ha7dcd/QRPi_WSPR_PCB/Eagle/20m_RPI_WSPR_TX_BOM_SMDmount.xlsx

Sheet: BOM_20m_RPI_WSPR_TX
 | BOM Version 1V1
Qty | Value | Newark website link | Device | Package | Parts | Description | DESCR | DISTRI | DISTRINR | MANUF | MANUFNR | MPN | OC_FARNELL | OC_NEWARK | PACKAGE | SUPPLIER | VENDOR
1 | 0.18uH | http://www.newark.com/taiyo-yuden/lbm2016tr18j/inductor-180nh-560ma-5-500mhz/dp/82T8627 | INDUCTOR_L_1210 | L1210 | L2 |  | Inductor, wirewound |  |  | TDK | NLCV32 series
2 | 0.27uH | http://www.newark.com/taiyo-yuden/brl3225tr27m/inductor-270nh-4-5a-20-390mhz/dp/82T8566 | INDUCTOR_L_1210 | L1210 | L0, L4 |  | Inductor, wirewound |  |  | TDK | NLCV32 series
2 | 0.56uH | http://www.newark.com/tdk/nlv32t-r56j-pf/signal-line-ind-56nh-450ma-5-180mhz/dp/89R9024 | INDUCTOR_L_1210 | L1210 | L6, L7 |  | Inductor, wirewound |  |  | TDK | NLCV32 series
1 | 1.2k | http://www.newark.com/yageo/rc0402jr-071k2l/thick-film-resistor-1-2kohm-62/dp/68R2086 | R-US_R0402 | R0402 | R2 | RESISTOR, American symbol
2 | 10nF | http://www.newark.com/multicomp/mc0603b103m500ct/ceramic-capacitor-0-01uf-50v-x7r/dp/06R4922 | CAP-SMD0603 | 0603 | C5, C11
1 | 1k | http://www.newark.com/yageo/rc0402jr-131kl/thick-film-resistor-1kohm-62-5mw/dp/68R0037 | R-US_R0402 | R0402 | R3 | RESISTOR, American symbol
2 | 2.7uH | http://www.newark.com/taiyo-yuden/lbm2016t2r7j/inductor-2-7uh-310ma-5-55mhz-smd/dp/82T8636 | INDUCTOR_L_1210 | L1210 | L1, L3 |  | Inductor, wirewound |  |  | TDK | NLCV32 series
3 | 220nF | http://www.newark.com/multicomp/mc0603f224z160ct/ceramic-capacitor-0-22uf-16v-y5v/dp/06R5085 | CAP-SMD0603 | 0603 | C_DC1, C_DC2, C_DC3
2 | 330p | http://www.newark.com/multicomp/mc0603b331k500ct/ceramic-capacitor-330pf-50v-x7r/dp/06R4989 | CAP-SMD0603 | 0603 | C10, C21
2 | 390p | http://www.newark.com/tdk/c1608c0g1h391j080aa/ceramic-capacitor-390pf-50v-c0g/dp/90R7654 | CAP-SMD0603 | 0603 | C0, C4
2 | 39p | http://www.newark.com/multicomp/mc0603n390j500ct/ceramic-capacitor-39pf-50v-c0g/dp/06R5174 | CAP-SMD0603 | 0603 | C1, C3
1 | 470p | http://www.newark.com/multicomp/mc0603b471k101ct/ceramic-capacitor-470pf-100v-x7r/dp/06R5014 | CAP-SMD0603 | 0603 | C2
2 | 47uH | http://www.newark.com/tdk/nlcv32t-470k-pf/power-line-ind-47uh-180ma-10-14mhz/dp/89R8888 | INDUCTOR_L_1210 | L1210 | LC1, LC2 |  | Inductor, wirewound |  |  | TDK | NLCV32 series
1 | 680p | http://www.newark.com/multicomp/mc0603b681k500ct/ceramic-capacitor-680pf-50v-x7r/dp/06R5042 | CAP-SMD0603 | 0603 | C7
1 | MMBF170-7-F | http://www.newark.com/fairchild-semiconductor/mmbf170/mosfet-full-reel/dp/67R2110 | MMBF170-7-F | SOT103P240X110-3N | Q1 | N-CHANNEL ENHANCEMENT MODE FIELD EFFECT TRANSISTOR |  |  |  |  |  | MMBF170-7-F | 1773582 | 51R6804 | SOT-23-3 | DIODES INC.
2 | N.F. |  | CAP-SMD0603 | 0603 | C6, C9
1 | PGB1010603NRHF Optional! | http://www.newark.com/littelfuse/pgb1010603nr/tvs-diode-24v-0603/dp/77J9736 | SMF33A-GS08_ESD0603 | 0603 | ESD1
1 | TERMINAL_WIRE_2P_17256562P | http://www.newark.com/phoenix-contact/1725656/terminal-block-pcb-2-position/dp/71C4107?ost=3041359 | TERMINAL_WIRE_2P_17256562P | WIRE_CONTACT_2P | ANT | PHOENIX CONTACT 1725656 TERMINAL BLOCK, WIRE TO BRD, 2POS, 20AWG |  | Farnell | 3041359 |  |  |  |  |  |  |  | Phonix
1 | smd header | http://www.newark.com/global-connector-technology/bg120-10-a-0-n-d/board-board-connector-socket-10way/dp/67R8627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 | PINHD-2X7_SMD2X7_CROSSPCB_ASSYM_DUMMY26PIN | 2X7-SMT_CROSSPCB_ASSYM_DUMY26HOLES | CON1 |  | RECEPTACLE, BOARD TO BOARD, 2ROW, 10WAY | Farnell | 2293771 | GLOBAL CONNECTOR TECHNOLOGY | BG120-10-A-0-N-D
 | Yellow marking means = | Not available in the requried size, just smaller footprint. Should fit and solderable.

Sheet: Mount SMD
Part | X [mm] | Y [mm] | Deg | Value | Package
C0 | 10.38 | 17.6 | 270 | 390p | 0603
C1 | 20.95 | 16.7 | 180 | 39p | 0603
C2 | 23.7 | 17.6 | 270 | 470p | 0603
C3 | 34.26 | 16.7 | 180 | 39p | 0603
C4 | 37.12 | 17.6 | 270 | 390p | 0603
C5 | 44.2 | 2.29 | 90 | 10nF | 0603
C6 | 31.46 | 7.45 | 0 | N.F. | 0603
C7 | 28.08 | 6.36 | 270 | 680p | 0603
C9 | 24.68 | 7.43 | 0 | N.F. | 0603
C10 | 21.3 | 6.36 | 270 | 330p | 0603
C11 | 35.78 | 2.37 | 180 | 10nF | 0603
C21 | 34.84 | 6.37 | 270 | 330p | 0603
CON1 | 4.27 | 10.07 | 90 | smd | header
C_DC1 | 10.38 | 13.8 | 270 | 220nF | 0603
C_DC2 | 43.26 | 12.39 | 90 | 220nF | 0603
C_DC3 | 18.53 | 4.97 | 0 | 220nF | 0603
ESD1 | 16.16 | 4.17 | 90 | PGB1010603NRHF | 0603
L0 | 12.64 | 18.3 | 270 | 0.27uH | L1210
L1 | 16.49 | 16.7 | 0 | 2.7uH | L1210
L2 | 25.95 | 18.3 | 270 | 0.18uH | L1210
L3 | 29.81 | 16.7 | 0 | 2.7uH | L1210
L4 | 39.37 | 18.3 | 270 | 0.27uH | L1210
L6 | 31.46 | 5.48 | 180 | 0.56uH | L1210
L7 | 24.65 | 5.47 | 180 | 0.56uH | L1210
LC1 | 42.31 | 2.79 | 270 | 47uH | L1210
LC2 | 38.75 | 3.89 | 270 | 47uH | L1210
Q1 | 40.57 | 7.29 | 270 | MMBF170-7-F | SOT103P240X110-3N
R2 | 42.93 | 6.1 | 90 | 1.2k | R0402
R3 | 44.2 | 6.1 | 270 | 1k | R0402

Sheet: PCB
Two layer
FR4
1.6mm thickness
1oz copper
