ha7dcd/QRPi_WSPR_PCB/KiCad/3dmodels/TerminalBlock_Phoenix_MPT-0,5-2-2.54_1x02_P2.54mm_Horizontal.step

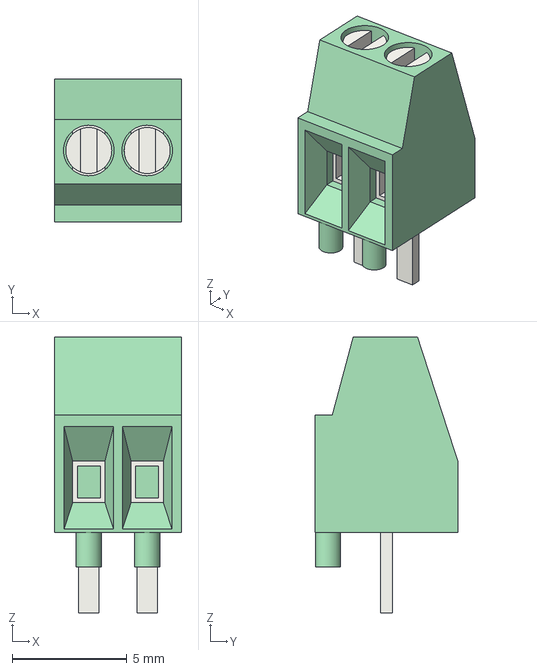
[picture p15: CAD file, 2026-10-26]
KiCad/3dmodels/TerminalBlock_Phoenix_MPT-0,5-2-2.54_1x02_P2.54mm_Horizontal.step
5.54 x 6.20 x 12.0 mm
