ha7dcd/QRPi_WSPR_PCB/KiCad/3dmodels/PinSocket_2x07_P2.54mm_Vertical_SMD.step

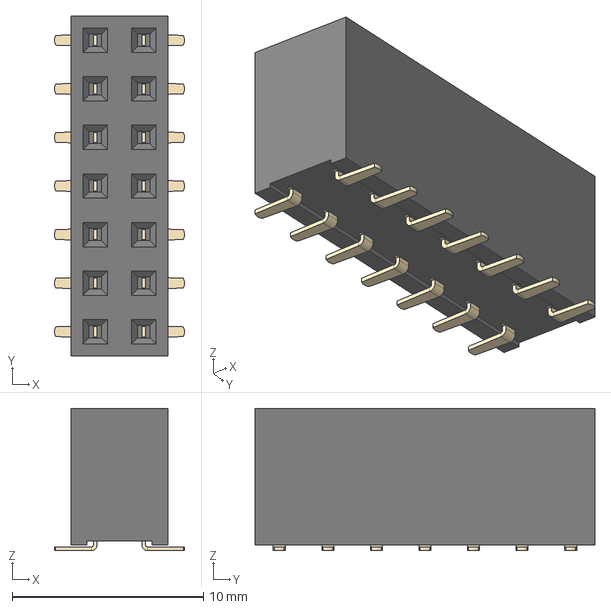
[picture p16: CAD file, 2026-10-26]
KiCad/3dmodels/PinSocket_2x07_P2.54mm_Vertical_SMD.step
6.80 x 17.8 x 7.45 mm
