ha7dcd/QRPi_WSPR_PCB/Eagle/20m_QRPi_1V6_bot.pdf

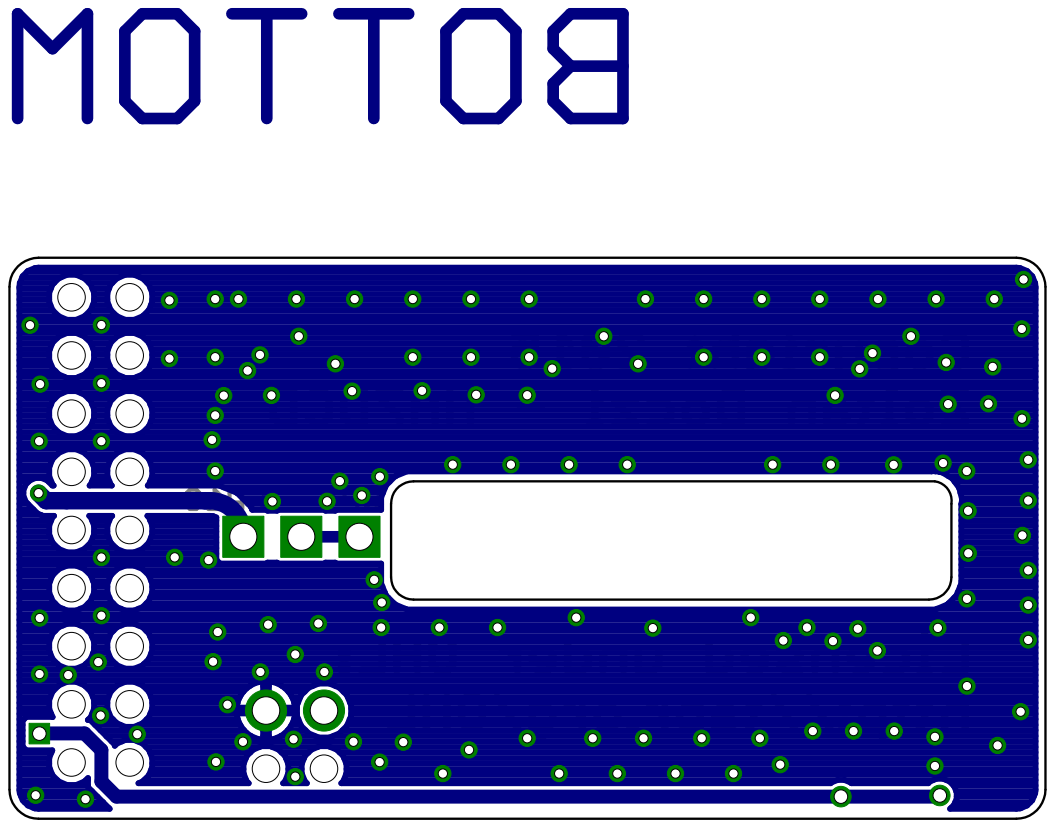
[picture p17: page 1]
