ha7dcd/QRPi_WSPR_PCB/Eagle/20m_QRPi_1V6_sch.pdf

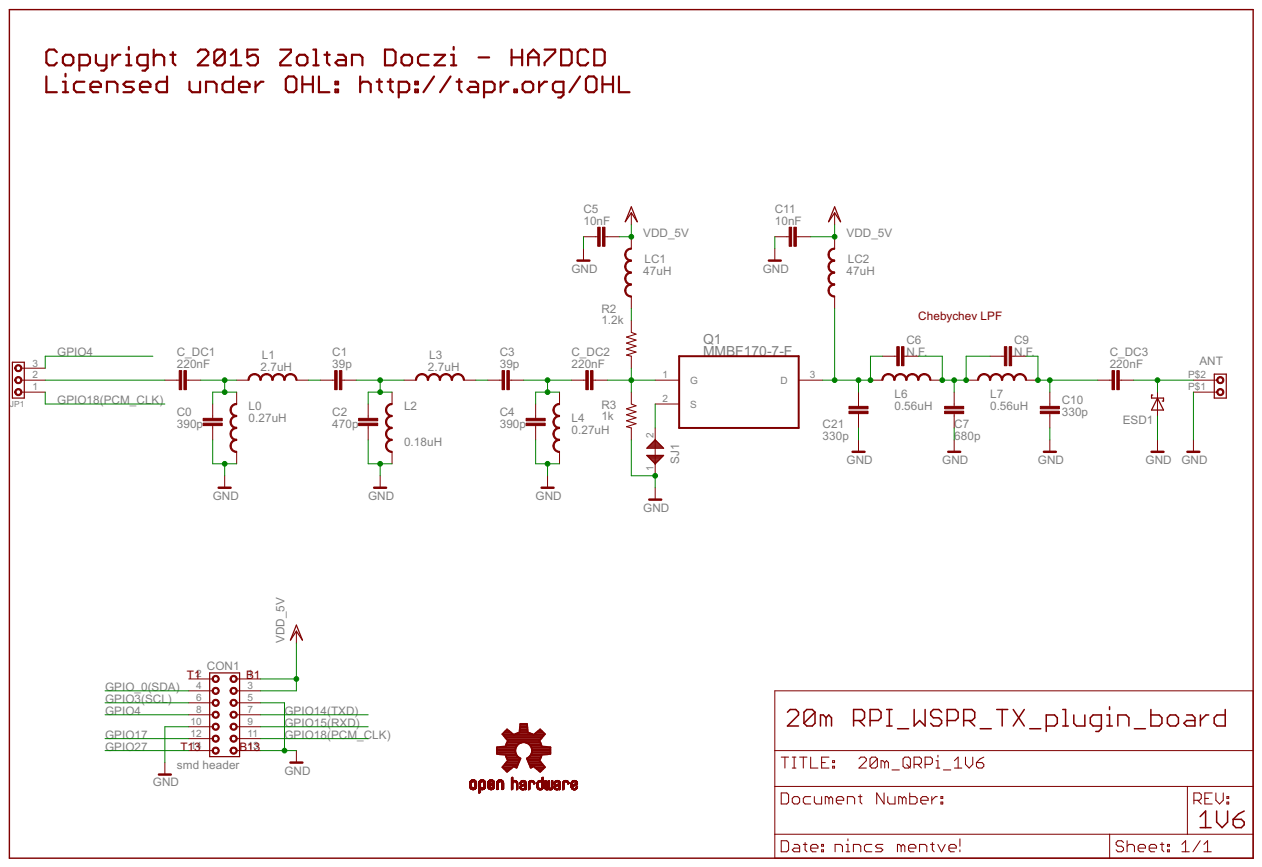
[picture p18: page 1]
