ha7dcd/QRPi_WSPR_PCB/Eagle/20m_QRPi_1V6_top.pdf

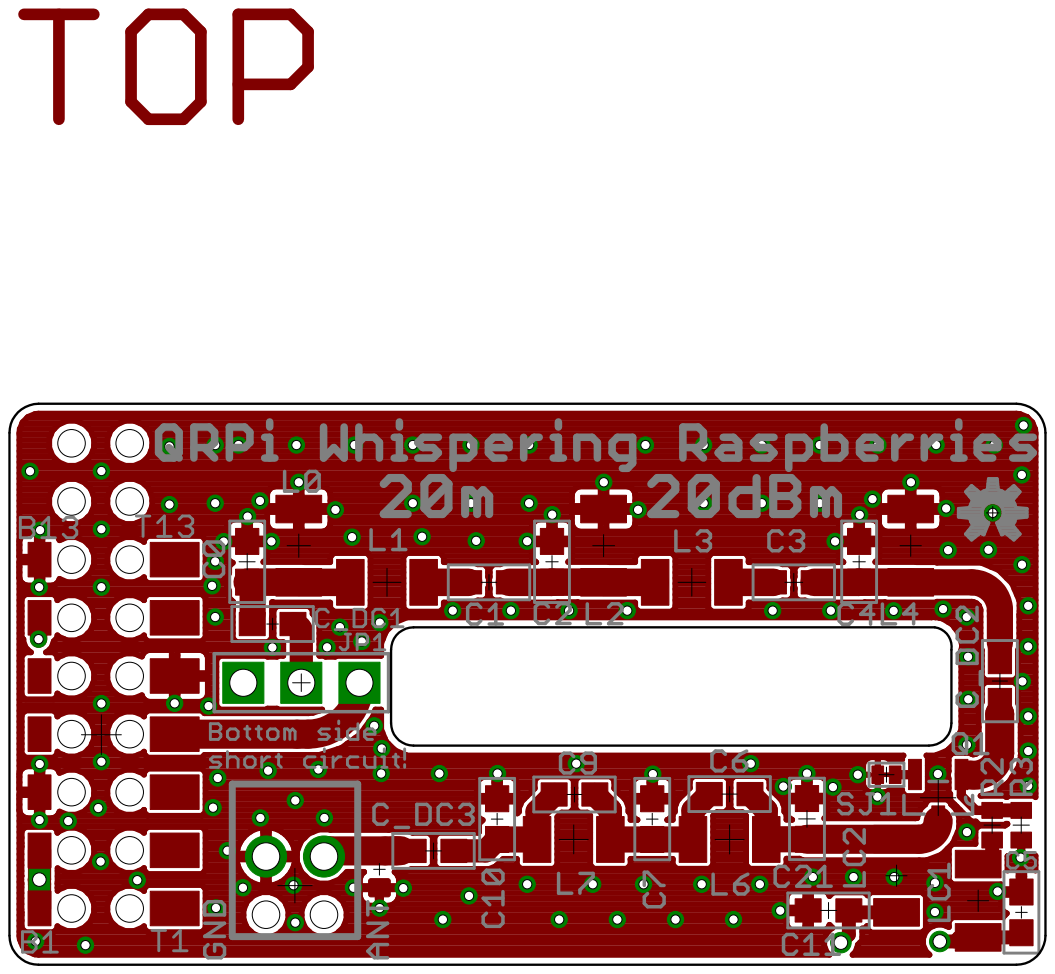
[picture p19: page 1]
