ha7dcd/QRPi_WSPR_PCB/Eagle/20m_QRPi_1V6.brd

## EAGLE design Eagle/20m_QRPi_1V6.brd (2026-10-26)

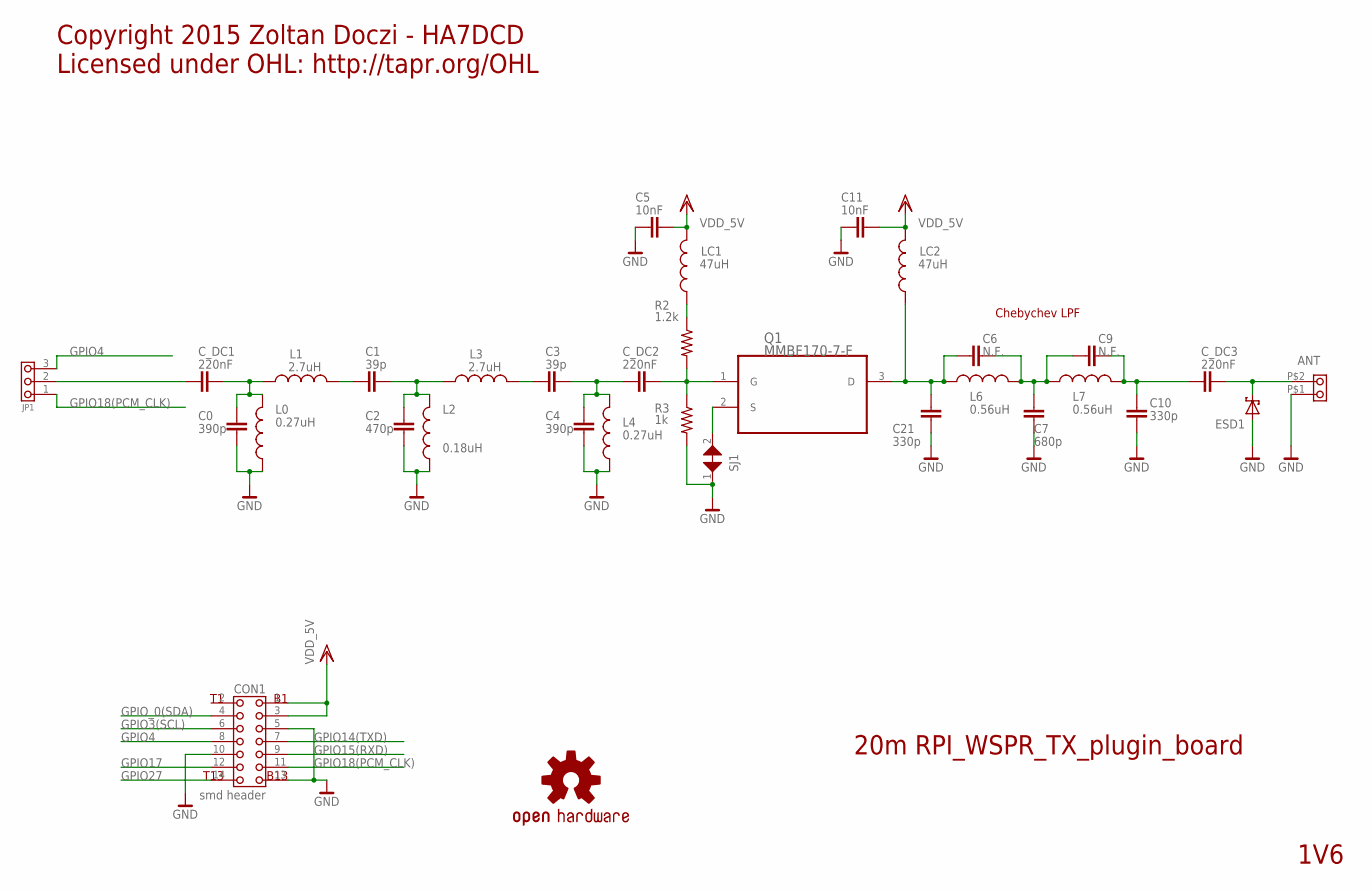
[picture p22: schematic 20m_QRPi_1V6.sch, GPS]

Parts:
ANT: TERMINAL_WIRE_2P_17256562P; WIRE_CONTACT_2P
C0, C4: 390p; 0603
C1, C3: 39p; 0603
C2: 470p; 0603
C5, C11: 10nF; 0603
C6, C9: N.F.; 0603
C7: 680p; 0603
C10, C21: 330p; 0603
CON1: smd header; 2X7-SMT_CROSSPCB_ASSYM_DUMY26HOLES
C_DC1, C_DC2, C_DC3: 220nF; 0603
ESD1: PGB1010603NRHF; 0603
JP1: N.F.; PIN3-B_SHORT23
L0, L4: 0.27uH; L1210
L1, L3: 2.7uH; L1210
L2: 0.18uH; L1210
L6, L7: 0.56uH; L1210
LC1, LC2: 47uH; L1210
Q1: MMBF170-7-F; SOT103P240X110-3N
R2: 1.2k; R0402
R3: 1k; R0402
SJ1: JUMPER_SMD_MICRO_SHORT
U$15: OSHW-LOGOS; OSHW-LOGO-S

Connections:
GND: ANT.P$1 (A), C0.1, C2.1, C4.1, C5.2, C7.1, C10.1, C11.2, C21.1, CON1.5, CON1.10, CON1.13, ESD1.1 (A), L0.1, L2.1, L4.1, R3.2, SJ1.1
GPIO3(SCL): CON1.6
GPIO4: CON1.8, JP1.3
GPIO14(TXD): CON1.7
GPIO15(RXD): CON1.9
GPIO17: CON1.12
GPIO18(PCM_CLK): CON1.11, JP1.1
GPIO27: CON1.14
GPIO_0(SDA): CON1.4
unnamed: C1.2, L1.2
unnamed: C0.2, C_DC1.1, L0.2, L1.1
unnamed: C_DC2.1, Q1.1 (G), R2.2, R3.1
unnamed: Q1.2 (S), SJ1.2
unnamed: LC1.1, R2.1
unnamed: C6.2, C21.2, L6.1, LC2.1, Q1.3 (D)
unnamed: C_DC1.2, JP1.2
unnamed: C3.1, C4.2, C_DC2.2, L4.2
unnamed: C6.1, C7.2, C9.2, L6.2, L7.1
unnamed: C1.1, C2.2, L2.2, L3.1
unnamed: C9.1, C10.2, C_DC3.2, L7.2
unnamed: C3.2, L3.2
unnamed: ANT.P$2 (B), C_DC3.1, ESD1.2 (C)
VDD_5V: C5.1, C11.1, CON1.1, CON1.3, LC1.2, LC2.2

Notes on the sheet:
20m RPI_WSPR_TX_plugin_board
1V6
Chebychev LPF
Copyright 2015 Zoltan Doczi - HA7DCD Licensed under OHL: http://tapr.org/OHL

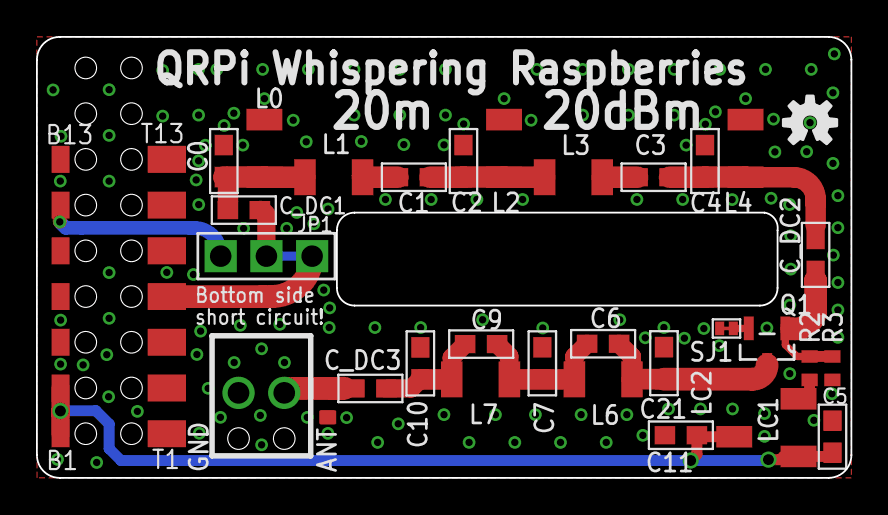
[picture p23: board 20m_QRPi_1V6.brd from above]

Board: 2 copper layers, 45.2 x 24.5 mm, 33 parts (0 on the bottom side), 17 nets.
