ha7dcd/QRPi_WSPR_PCB/(commit log)

2026-10-26 Add EAGLE design files and manufacturing Gerbers (rev 1.6)
2026-10-26 Add KiCad 10 version with 3D models, DCC 2015 paper, photo and README
    KiCad project converted from the EAGLE rev 1.6 files and checked against them and the original Gerbers; STEP models from the KiCad library for 30 of 33 footprints.
2026-10-26 README: banner (measured spectra from the DCC 2015 paper, WSPR symbols, prototype photo, 3D render)
