ha7dcd/QRPi_WSPR_PCB/(notices)

Notices in the files:
KiCad/3dmodels/PinSocket_2x07_P2.54mm_Vertical_SMD.step:
Copyright (C) 2024, KiCAD
This work is licensed under the
[Creative Commons CC-BY-SA 4.0 License](https://creativecommons.org/licenses/by-sa/4.0/legalcode),
with the following exception:
project files under this or any other license agreement. However, if you wish to distribute
KiCad/3dmodels/TerminalBlock_Phoenix_MPT-0,5-2-2.54_1x02_P2.54mm_Horizontal.step:
Copyright (C) 2026, KiCAD
